paolometeo/MultiOptics/README.md

# MultiOptics
Colorimeter and Turbidimeter for Arduino
